hemanthmadhavdone-png/off-grid-emergency-self-healing-lora-mesh/docs/Project.jpeg

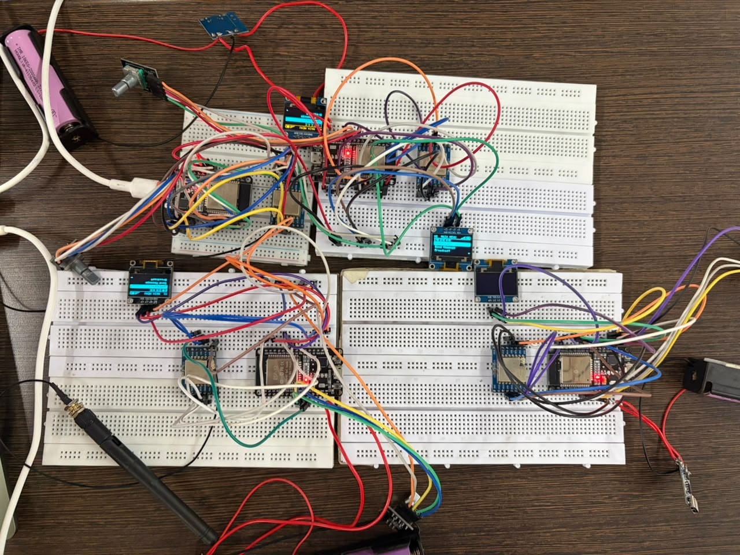
docs/Project.jpeg
