hemanthmadhavdone-png/off-grid-emergency-self-healing-lora-mesh/firmware/README.md

# Firmware

This directory contains the Arduino firmware for the four-node ESP32-LoRa mesh network.
The firmware implements the node communication and message-forwarding logic used by the project.
Refer to the source files and project report for hardware configuration, node IDs, dependencies, and setup instructions.
If the nodes share the same firmware, their individual identities and configuration are documented here.
