hemanthmadhavdone-png/off-grid-emergency-self-healing-lora-mesh/docs/network_architecture.png

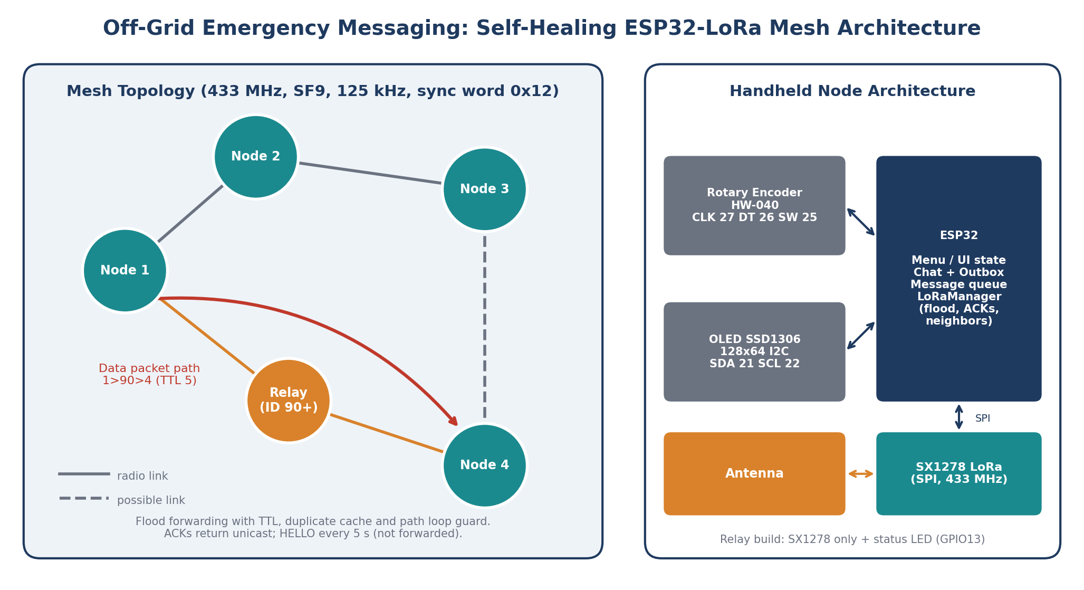
docs/network_architecture.png
